willplatts/led_controller/README.md

# led_controller
LED array PCB for lighting with daisy chain controller
