willplatts/led_controller/HW/led_controller/gerbers/BOM.xlsx

Ref | Value | Part | Manufacturer part no | Supplier | Qty
C1, C2, C4, C5 | 4.7u | Capacitor, 1206, 4.7uF, X5R, 25V | Generic | DIGI 1276-2880-1-ND | 4
C3, C6, C7 | 100n | Capacitor, 0603, 100nF, X7R, 50V | Generic | DIGI 1276-CL10B104KB8NNNLCT-ND | 3
D1-D48 | LED_Small | LED, white, 2835 | CREE JE2835AWT-00-0000-0B0A0UF840E | DIGI JE2835AWT-00-0000-0B0A0UF840ECT-ND | 48
F1 | 1A | Fuse, SMD 1206, 1A | BEL FUSE C1F 1 | DIGI 507-1878-1-ND | 1
J1, J2 | Conn_01x04_Female | Pin header, 2.54mm, 1x4 | TE 640454-4 | DIGI A19431-ND | 2
J3 | Screw_Terminal_01x02 | Screw terminal, 5mm, 1x2 | PHOENIX CONTACT 1935161 | DIGI 277-1667-ND | 1
J4 | Conn_ARM_JTAG_SWD_10 | Conn JTAG 2x5 | CNC TECH 3221-10-0100-00 | DIGI 1175-1733-ND | 1
MK1 | CMEJ-0415-42-P | Microphone, CMEJ-0415-42-P | CUI CMEJ-0415-42-P | DIGI 102-6542-ND | 1
Q1 | BC817 | Transistor, NPN, BC817, SOT-23 | ON SEMI BC817-16LT3G | DIGI BC817-16LT3GOSCT-ND | 1
R1-R5, R9 | 1k | Resistor, 0603, 1k | Generic | DIGI RHM1.0KDCT-ND | 6
R6 | 2.2k | Resistor, 0603, 2.2k | Generic | DIGI A130093CT-ND | 1
R7 | 100k | Resistor, 0603, 100k | Generic | DIGI CR0603-JW-104ELFCT-ND | 1
R8 | 10k | Resistor, 0603, 10k | Generic | DIGI RNCP0603FTD10K0CT-ND | 1
U1 | ATSAMD09C | MCU ATSAMD09C, SOIC-14 | MICROCHIP ATSAMD09C13A-SSUT | DIGI ATSAMD09C13A-SSUTCT-ND | 1
U2 | TLC5971PWP | LED Driver, HTSSOP-20 | TI TLC5971PWPR | DIGI 296-27796-1-ND | 1
DIGIKEY | https://www.digikey.co.uk/short/prp19m
