willplatts/led_controller/HW/led_controller/gerbers/led_controller.pdf

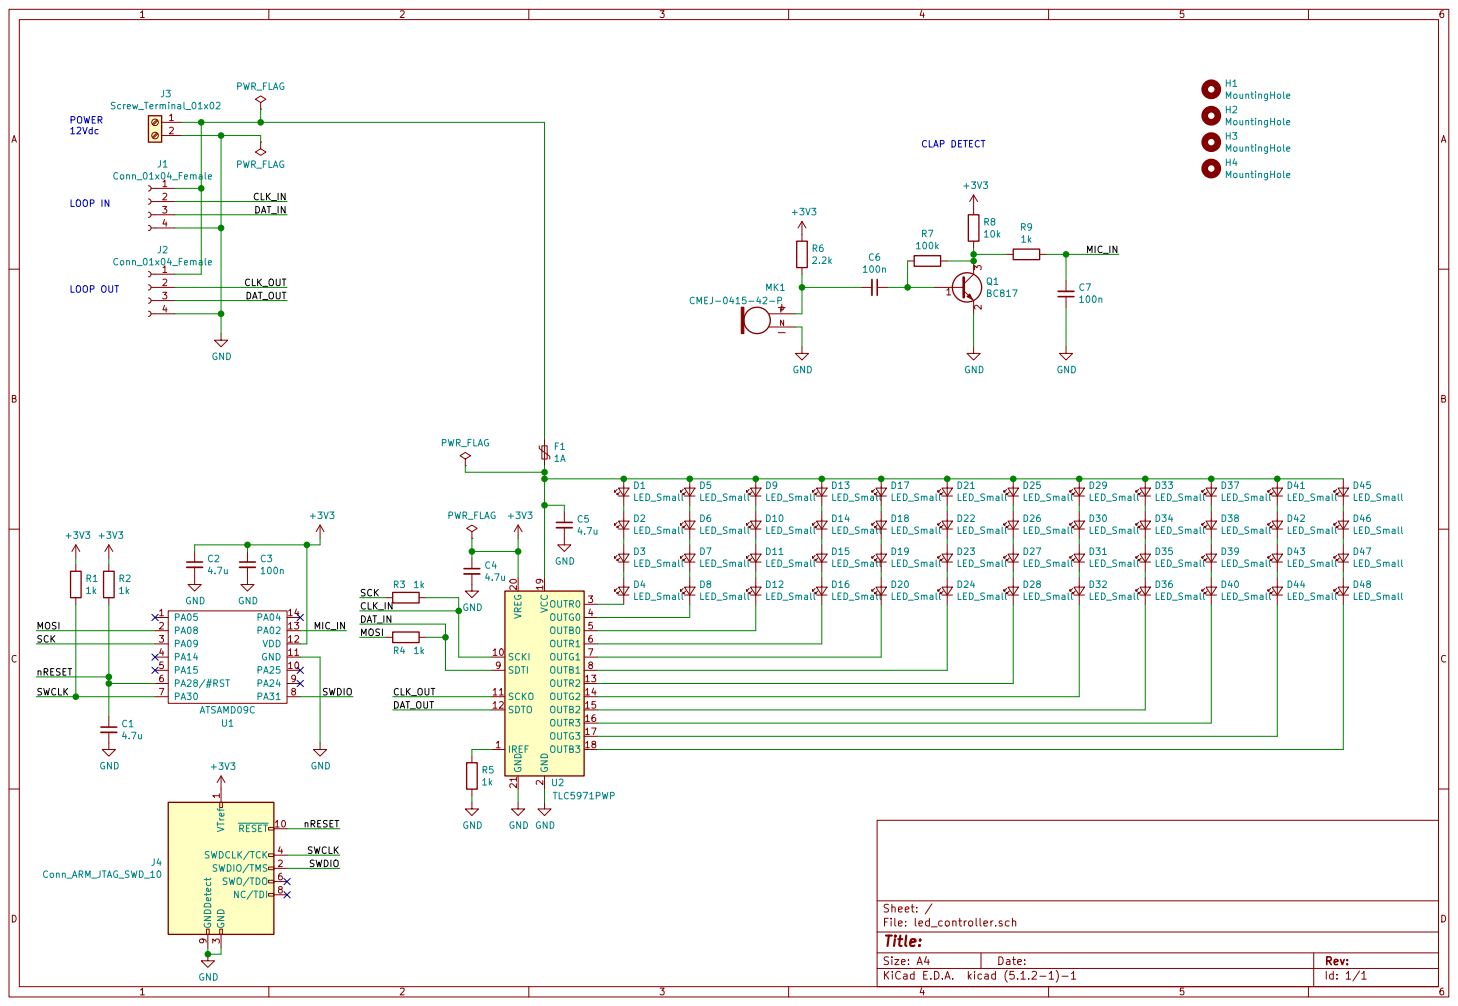
[picture p1: page 1]

3 SWDCLK/TCK 4 SWO/TDO 6 NC/TDI 8 GNDDetect 9
