willplatts/led_controller/HW/led_controller/led_controller.kicad_pcb

## KiCad design HW/led_controller/led_controller.kicad_pcb (2019-08-19)

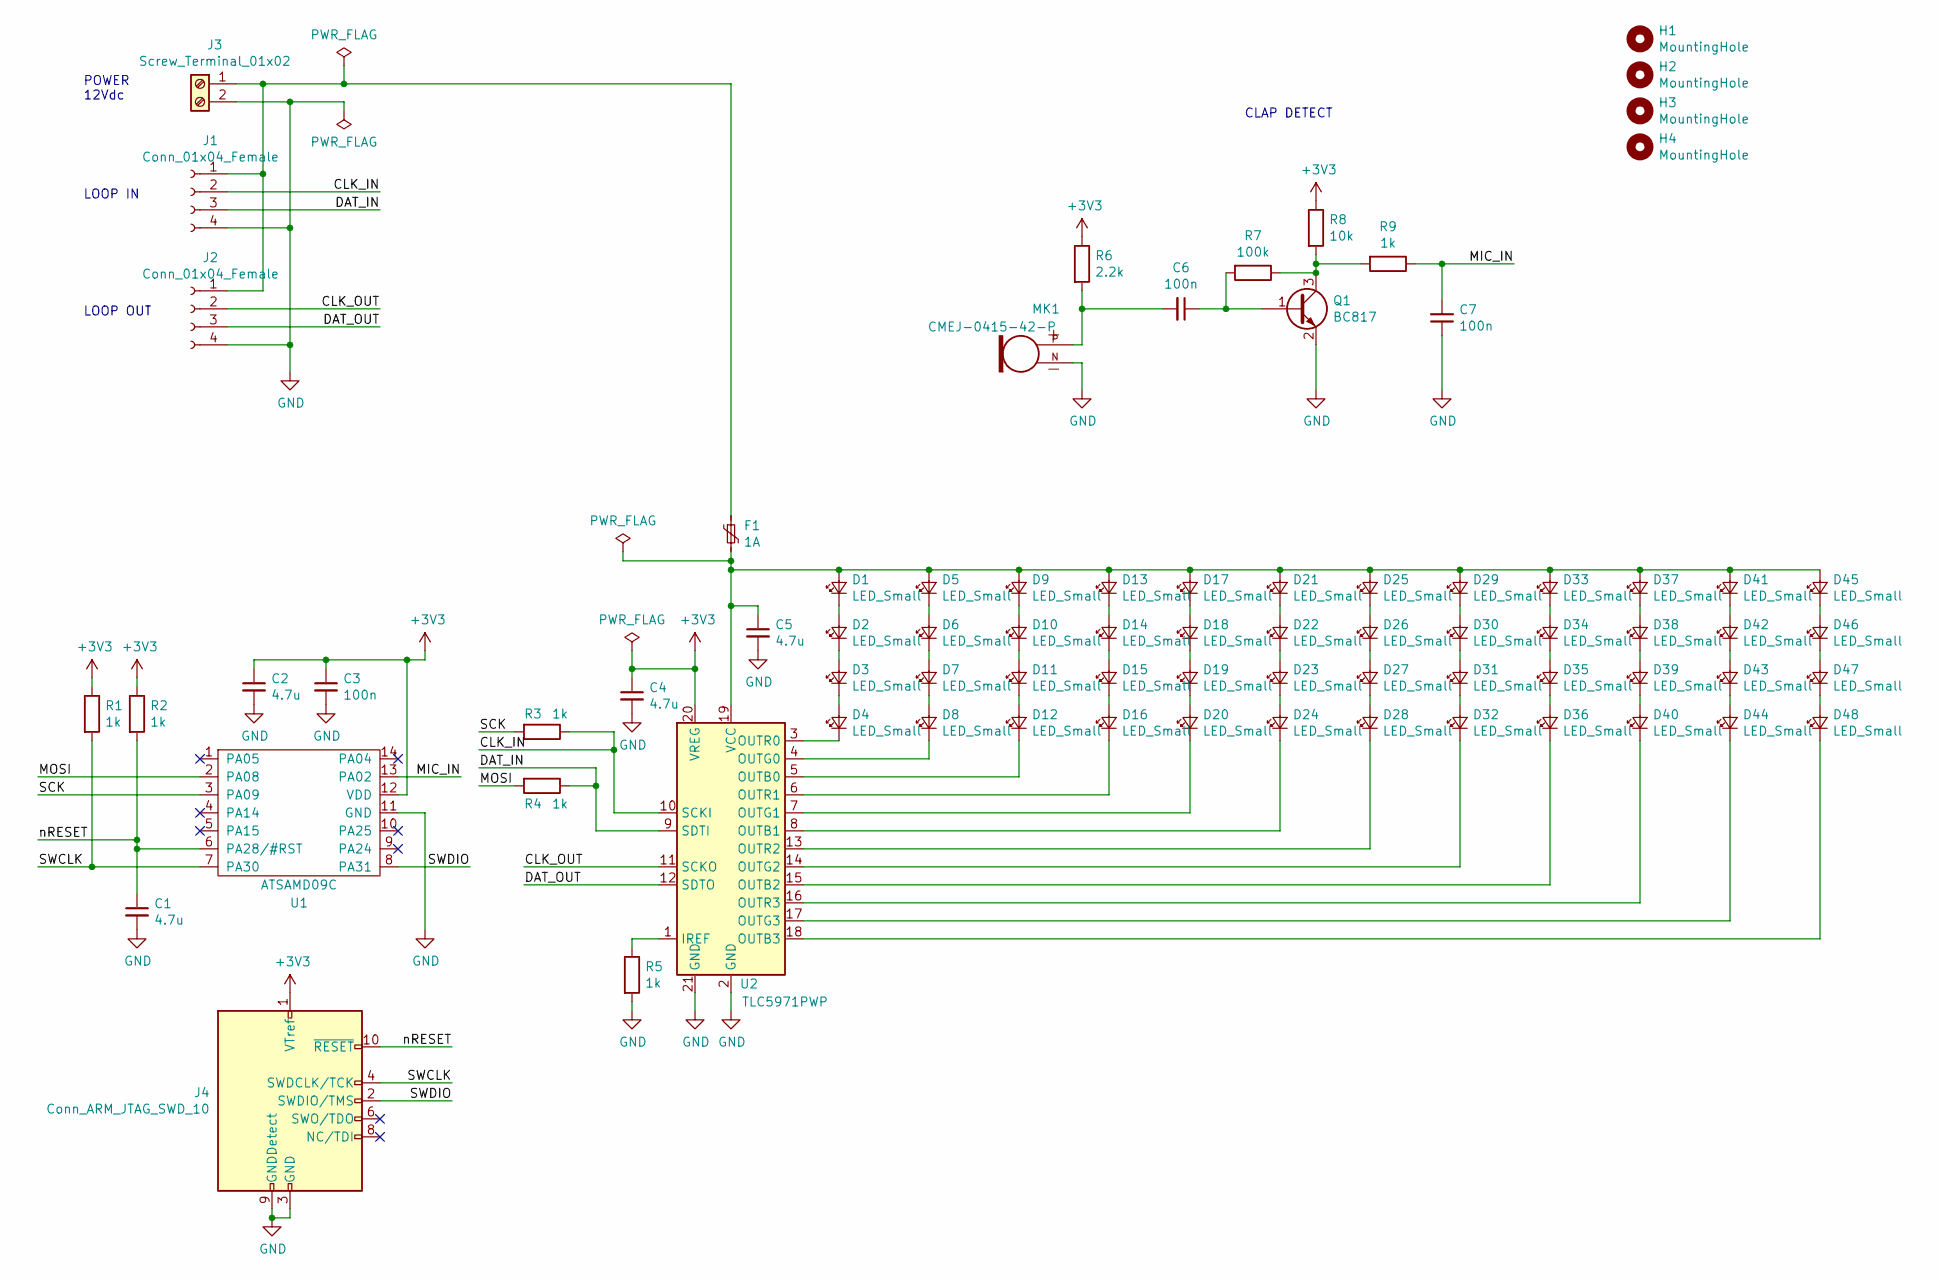
[picture p2: schematic led_controller.sch]

Parts:
C1, C2, C4, C5: 4.7u; C_1206_3216Metric_Pad1.42x1.75mm_HandSolder
C3, C6, C7: 100n; C_0603_1608Metric_Pad1.05x0.95mm_HandSolder
D1, D2, D3, D4, D5, D6, D7, D8, D9, D10, D11, D12, D13, D14, D15, D16, D17, D18, D19, D20, D21, D22, D23, D24, D25, D26, D27, D28, D29, D30, D31, D32, D33, D34, D35, D36, D37, D38, D39, D40, D41, D42, D43, D44, D45, D46, D47, D48: LED_Small; LED_PLCC_2835_Handsoldering
F1: 1A; R_1206_3216Metric_Pad1.42x1.75mm_HandSolder
H1, H2, H3, H4: MountingHole; MountingHole_3.2mm_M3
J1, J2: Conn_01x04_Female; PinHeader_1x04_P2.54mm_Vertical
J3: Screw_Terminal_01x02; TerminalBlock_Phoenix_MKDS-1,5-2_1x02_P5.00mm_Horizontal
J4: Conn_ARM_JTAG_SWD_10; PinHeader_2x05_P1.27mm_Vertical
MK1: CMEJ-0415-42-P; MIC_CMEJ-0415-42-P
Q1: BC817; SOT-23
R1, R2, R3, R4, R5, R9: 1k; R_0603_1608Metric_Pad1.05x0.95mm_HandSolder
R6: 2.2k; R_0603_1608Metric_Pad1.05x0.95mm_HandSolder
R7: 100k; R_0603_1608Metric_Pad1.05x0.95mm_HandSolder
R8: 10k; R_0603_1608Metric_Pad1.05x0.95mm_HandSolder
U1: ATSAMD09C; SOIC-14_3.9x8.7mm_P1.27mm
U2: TLC5971PWP; HTSSOP-20-1EP_4.4x6.5mm_P0.65mm_EP3.4x6.5mm_Mask2.75x3.43mm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

Connections:
+3V3: C2.1, C3.1, C4.1, J4.1 (VTref), R1.1, R2.1, R6.1, R8.1, U1.12 (VDD), U2.20 (VREG)
/CLK_IN: J1.2, R3.1, U2.10 (SCKI)
/CLK_OUT: J2.2, U2.11 (SCKO)
/DAT_IN: J1.3, R4.1, U2.9 (SDTI)
/DAT_OUT: J2.3, U2.12 (SDTO)
/MIC_IN: C7.2, R9.1, U1.13 (PA02)
/MOSI: R4.2, U1.2 (PA08)
/SCK: R3.2, U1.3 (PA09)
/SWCLK: J4.4 (SWDCLK/TCK), R1.2, U1.7 (PA30)
/SWDIO: J4.2 (SWDIO/TMS), U1.8 (PA31)
/nRESET: C1.1, J4.10 (~RESET~), R2.2, U1.6 (PA28/#RST)
GND: C1.2, C2.2, C3.2, C4.2, C5.2, C7.1, J1.4, J2.4, J3.2, J4.3 (GND), J4.5 (GND), J4.9 (GNDDetect), MK1.N (GND), Q1.2 (E), R5.2, U1.11 (GND), U2.2 (GND), U2.21 (GND)
unnamed: C5.1, D1.2 (A), D5.2 (A), D9.2 (A), D13.2 (A), D17.2 (A), D21.2 (A), D25.2 (A), D29.2 (A), D33.2 (A), D37.2 (A), D41.2 (A), D45.2 (A), F1.2, U2.19 (VCC)
unnamed: C6.1, Q1.1 (B), R7.2
unnamed: C6.2, MK1.P (OUTPUT), R6.2
unnamed: D1.1 (K), D2.2 (A)
unnamed: D2.1 (K), D3.2 (A)
unnamed: D3.1 (K), D4.2 (A)
unnamed: D4.1 (K), U2.3 (OUTR0)
unnamed: D5.1 (K), D6.2 (A)
unnamed: D6.1 (K), D7.2 (A)
unnamed: D7.1 (K), D8.2 (A)
unnamed: D8.1 (K), U2.4 (OUTG0)
unnamed: D10.1 (K), D11.2 (A)
unnamed: D9.1 (K), D10.2 (A)
unnamed: D11.1 (K), D12.2 (A)
unnamed: D12.1 (K), U2.5 (OUTB0)
unnamed: D13.1 (K), D14.2 (A)
unnamed: D14.1 (K), D15.2 (A)
unnamed: D15.1 (K), D16.2 (A)
unnamed: D16.1 (K), U2.6 (OUTR1)
unnamed: D17.1 (K), D18.2 (A)
unnamed: D18.1 (K), D19.2 (A)
unnamed: D19.1 (K), D20.2 (A)
unnamed: D20.1 (K), U2.7 (OUTG1)
unnamed: D21.1 (K), D22.2 (A)
unnamed: D22.1 (K), D23.2 (A)
unnamed: D23.1 (K), D24.2 (A)
unnamed: D24.1 (K), U2.8 (OUTB1)
unnamed: D25.1 (K), D26.2 (A)
unnamed: D26.1 (K), D27.2 (A)
unnamed: D27.1 (K), D28.2 (A)
unnamed: D28.1 (K), U2.13 (OUTR2)
unnamed: D29.1 (K), D30.2 (A)
unnamed: D30.1 (K), D31.2 (A)
unnamed: D31.1 (K), D32.2 (A)
unnamed: D32.1 (K), U2.14 (OUTG2)
unnamed: D33.1 (K), D34.2 (A)
unnamed: D34.1 (K), D35.2 (A)
unnamed: D35.1 (K), D36.2 (A)
unnamed: D36.1 (K), U2.15 (OUTB2)
unnamed: D37.1 (K), D38.2 (A)
unnamed: D38.1 (K), D39.2 (A)
unnamed: D39.1 (K), D40.2 (A)
unnamed: D40.1 (K), U2.16 (OUTR3)
unnamed: D41.1 (K), D42.2 (A)
unnamed: D42.1 (K), D43.2 (A)
unnamed: D43.1 (K), D44.2 (A)
unnamed: D44.1 (K), U2.17 (OUTG3)
unnamed: D45.1 (K), D46.2 (A)
unnamed: D46.1 (K), D47.2 (A)
unnamed: D47.1 (K), D48.2 (A)
unnamed: D48.1 (K), U2.18 (OUTB3)
unnamed: F1.1, J1.1, J2.1, J3.1
unnamed: Q1.3 (C), R7.1, R8.2, R9.2
unnamed: R5.1, U2.1 (IREF)

Notes on the sheet:
LOOP IN
LOOP OUT
POWER 12Vdc
CLAP DETECT

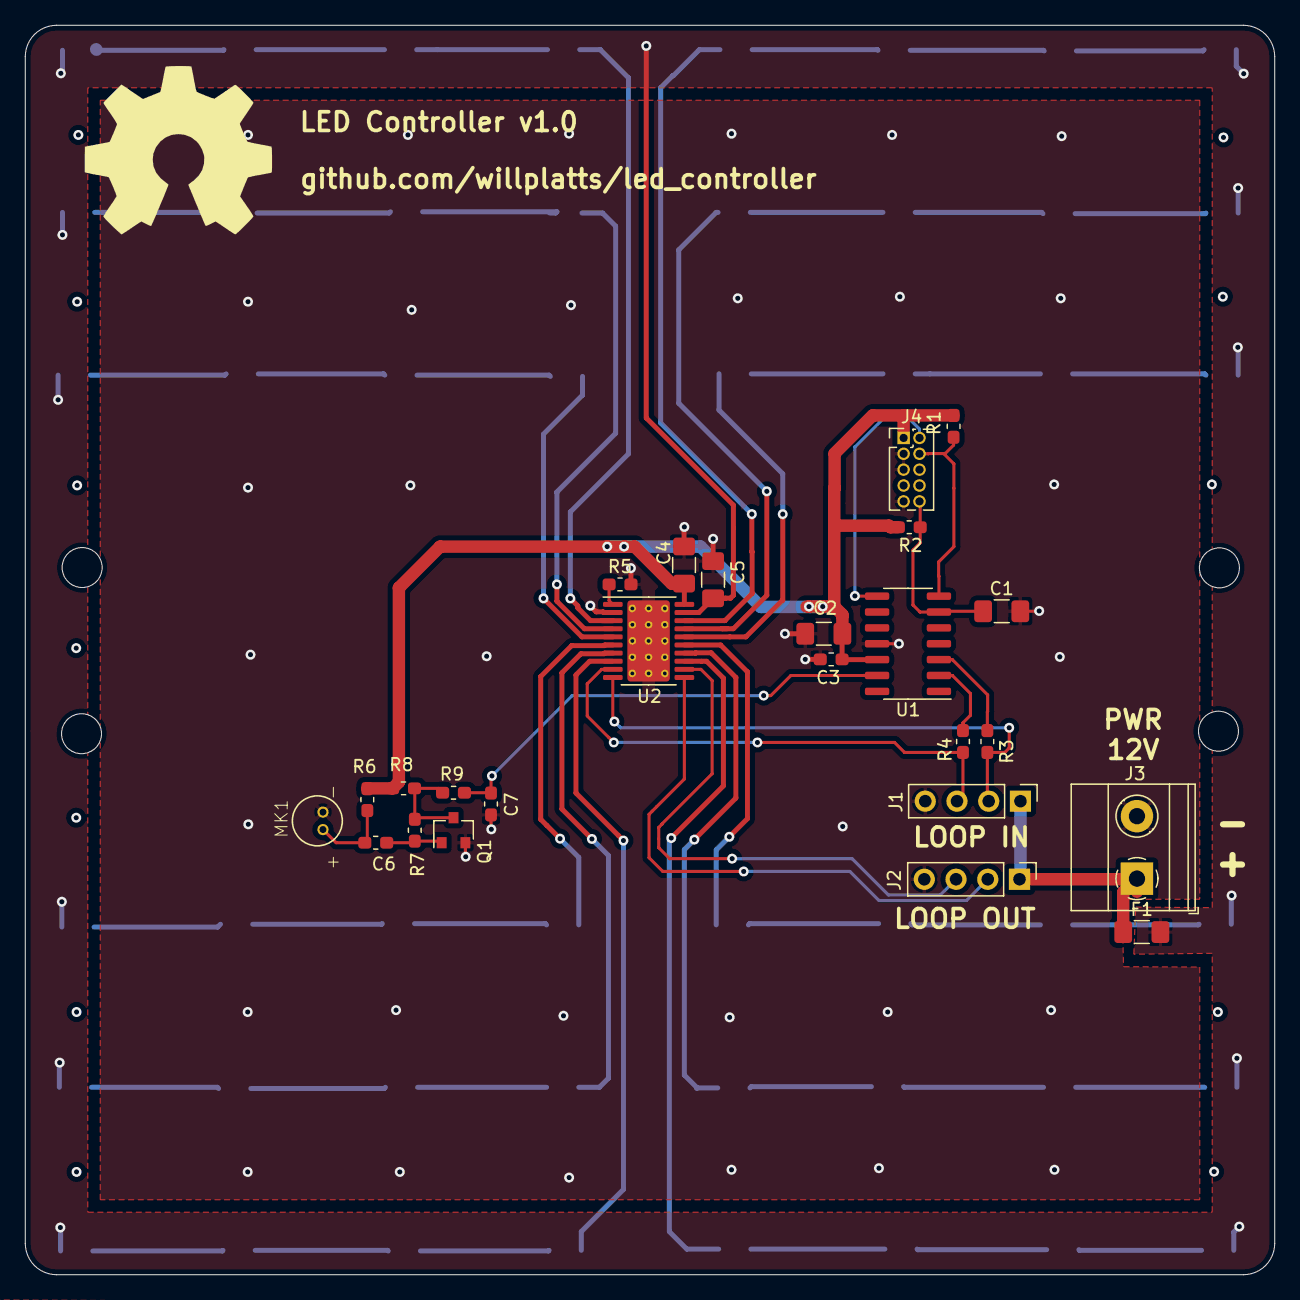
[picture p3: board led_controller.kicad_pcb from above]

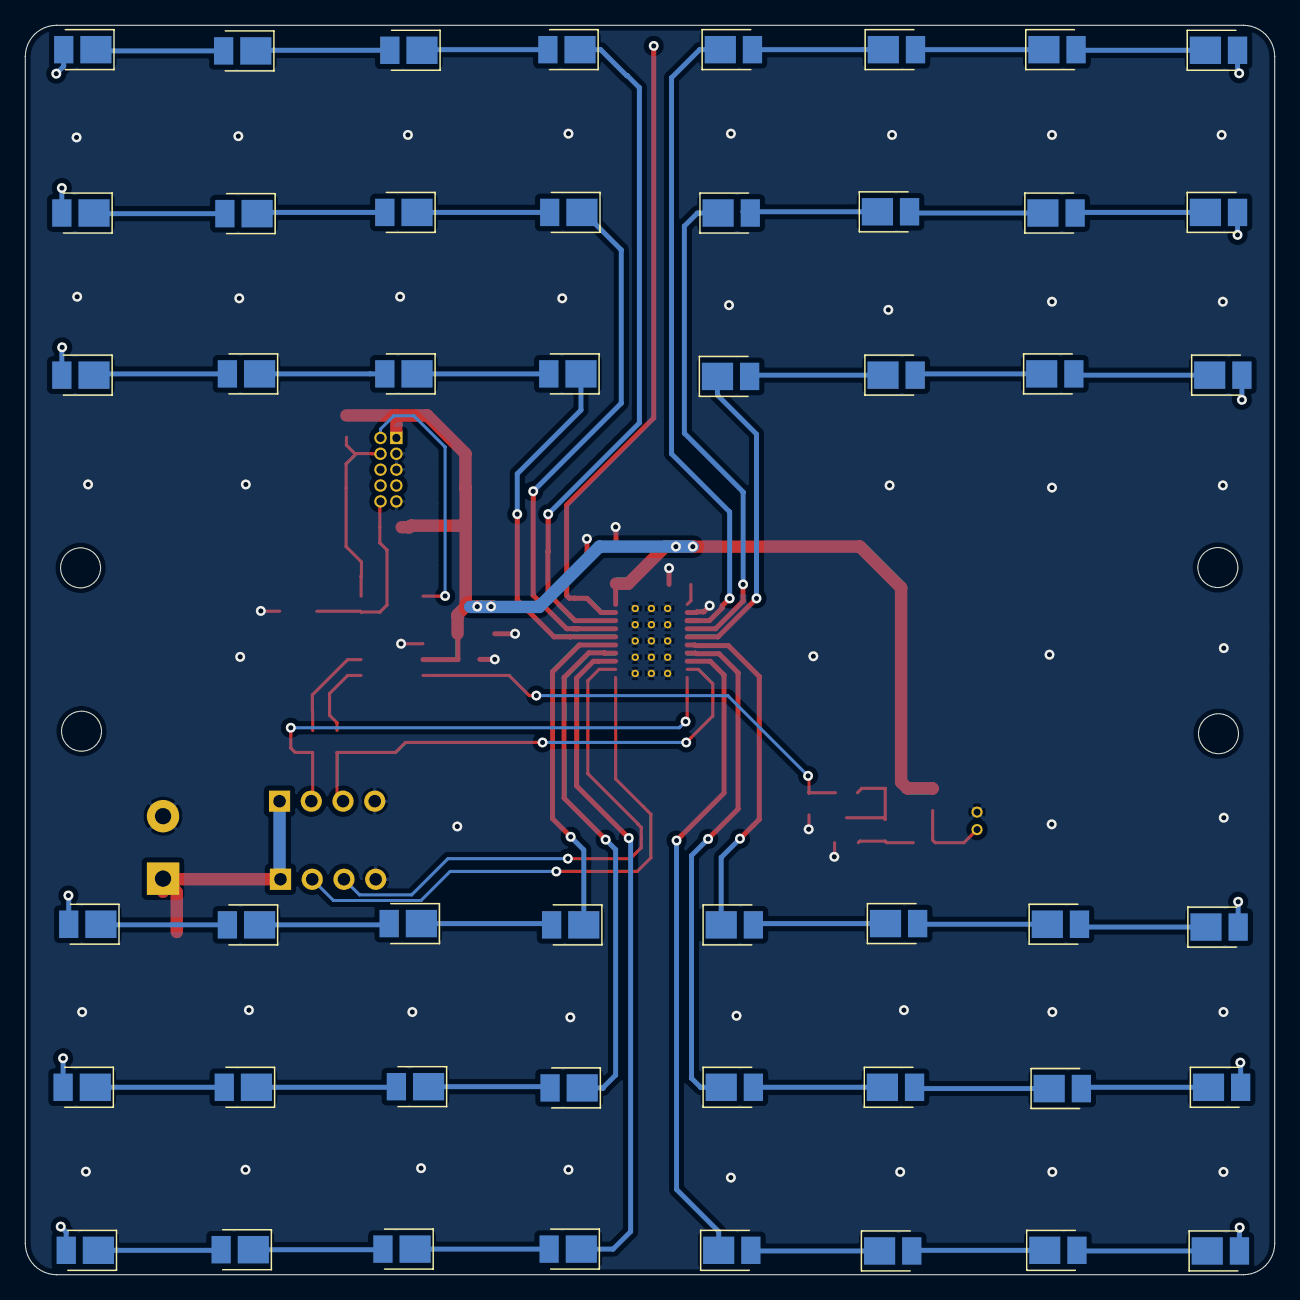
[picture p4: board led_controller.kicad_pcb from below]

Board: 2 copper layers, 100.0 x 100.0 mm, 77 parts (48 on the bottom side), 66 nets.
