willplatts/led_controller/(commit log)

2019-08-15 Adding PCB design so far
    [led_controller.kicad_pcb, led_controller.sch]
2019-08-15 Changing microphone to CMEJ-0415-42-P, mostly finished PCB, DRC passing, adding OSH logo and some text
    [led_controller.kicad_pcb, led_controller.sch]
2019-08-19 Completing PCB design, adding gerbers and PDF schematic
    [led_controller.kicad_pcb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]
2019-08-27 Adding excel BOM
    [BOM.xlsx]
